Qv1k-bits/sim7080_dev_board/SIM7080.kicad_pcb

## KiCad design SIM7080.kicad_pcb (2024-02-22)

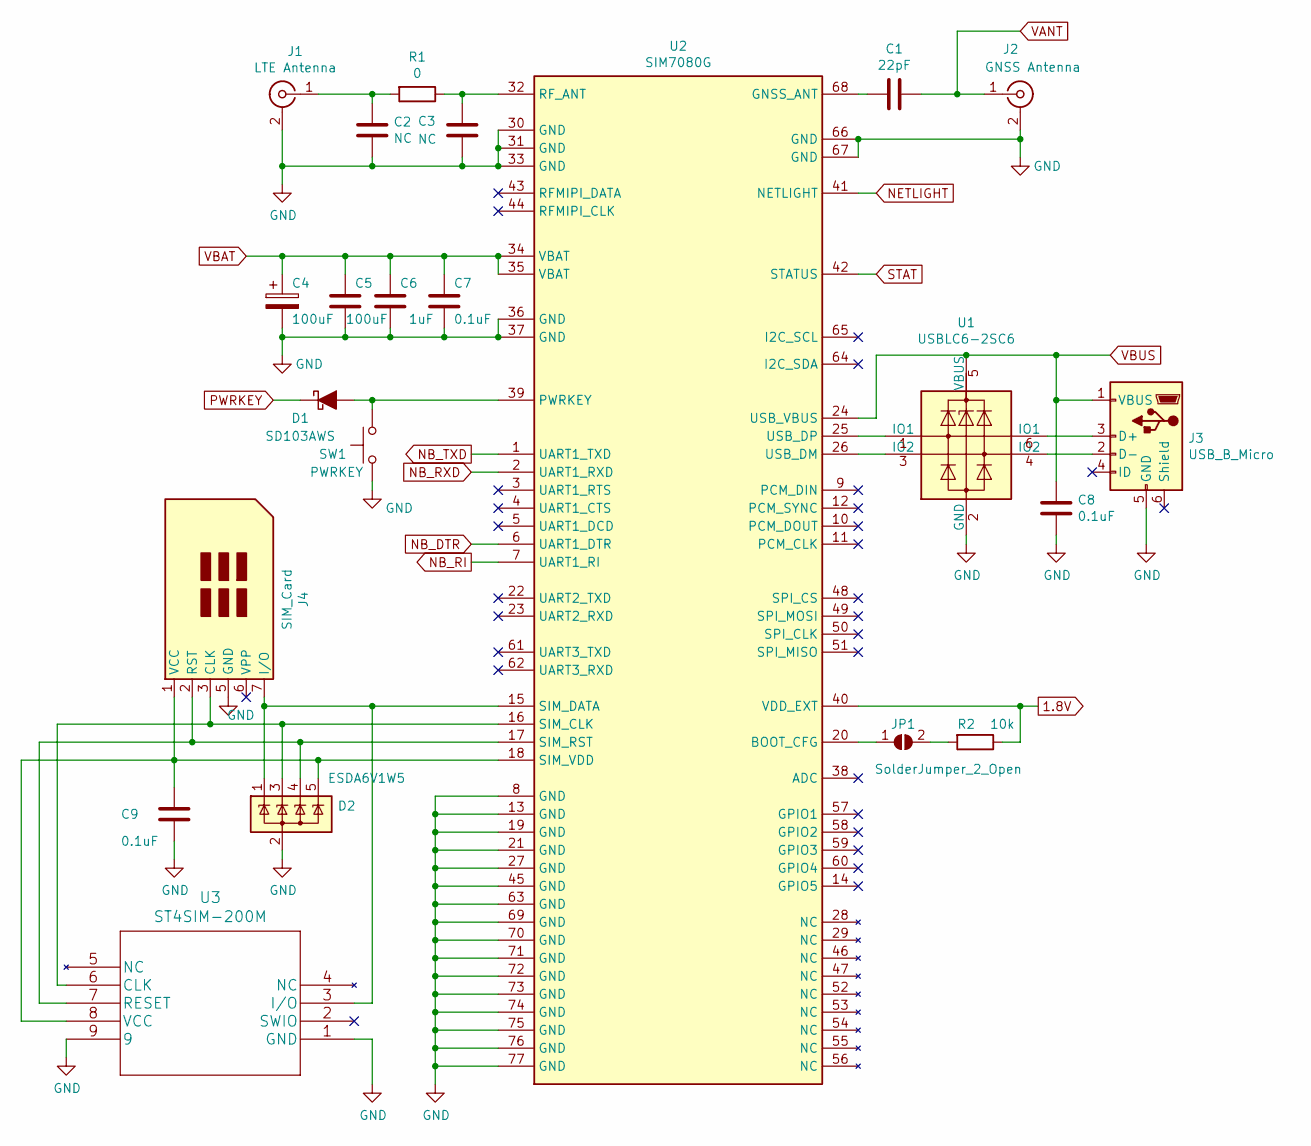
[picture p1: schematic SIM7080_module.kicad_sch, TechStudio.Design SIM7080G NB-IoT Shield]

Parts:
C1: 22pF; C_0603_1608Metric_Pad1.05x0.95mm_HandSolder
C2, C3: NC; C_0603_1608Metric_Pad1.05x0.95mm_HandSolder
C4: 100uF; CP_EIA-3528-12_Kemet-T_Pad1.50x2.35mm_HandSolder
C5: 100uF; C_1206_3216Metric_Pad1.42x1.75mm_HandSolder
C6: 1uF; C_0603_1608Metric_Pad1.05x0.95mm_HandSolder
C7, C8, C9: 0.1uF; C_0603_1608Metric_Pad1.05x0.95mm_HandSolder
D1: SD103AWS; D_SOD-323_HandSoldering
D2: ESDA6V1W5; SOT-353_SC-70-5_Handsoldering
J1: LTE Antenna; U.FL_Hirose_U.FL-R-SMT-1_Vertical
J2: GNSS Antenna; U.FL_Hirose_U.FL-R-SMT-1_Vertical
J3: USB_B_Micro; U254-051T-4BH83
J4: SIM_Card; HOAUC-HYC240-SIM-06-150_C645501
JP1: SolderJumper_2_Open; SolderJumper-2_P1.3mm_Open_Pad1.0x1.5mm
R1: 0; R_0603_1608Metric_Pad1.05x0.95mm_HandSolder
R2: 10k; R_0603_1608Metric_Pad1.05x0.95mm_HandSolder
SW1: PWRKEY; SW_TS-1101-X-X
U1: USBLC6-2SC6; SOT-23-6_Handsoldering
U2: SIM7080G
U3: ST4SIM-200M

Connections:
1.8V: R2.1, U2.40 (VDD_EXT); also elsewhere on the board
GND: C2.2, C3.2, C4.2, C5.2, C6.2, C7.2, C8.2, C9.2, D2.2 (A), J1.2 (Ext), J2.2 (Ext), J3.5 (GND), J4.5 (GND), SW1.1, U1.2 (GND), U2.8 (GND), U2.13 (GND), U2.19 (GND), U2.21 (GND), U2.27 (GND), U2.30 (GND), U2.31 (GND), U2.33 (GND), U2.36 (GND), U2.37 (GND), U2.45 (GND), U2.63 (GND), U2.66 (GND), U2.67 (GND), U2.69 (GND), U2.70 (GND), U2.71 (GND), U2.72 (GND), U2.73 (GND), U2.74 (GND), U2.75 (GND), U2.76 (GND), U2.77 (GND), U3.1 (GND), U3.9; also elsewhere on the board
NB_DTR: U2.6 (UART1_DTR); also elsewhere on the board
NB_RI: U2.7 (UART1_RI); also elsewhere on the board
NB_RXD: U2.2 (UART1_RXD); also elsewhere on the board
NB_TXD: U2.1 (UART1_TXD); also elsewhere on the board
NETLIGHT: U2.41 (NETLIGHT); also elsewhere on the board
unnamed: C1.1, U2.68 (GNSS_ANT)
unnamed: C2.1, J1.1 (In), R1.2
unnamed: C3.1, R1.1, U2.32 (RF_ANT)
unnamed: C9.1, D2.5 (K), J4.1 (VCC), U2.18 (SIM_VDD), U3.8 (VCC)
unnamed: D1.2 (A), SW1.2, U2.39 (PWRKEY)
unnamed: D2.1 (K), J4.7 (I/O), U2.15 (SIM_DATA), U3.3 (I/O)
unnamed: D2.3 (K), J4.3 (CLK), U2.16 (SIM_CLK), U3.6 (CLK)
unnamed: D2.4 (K), J4.2 (RST), U2.17 (SIM_RST), U3.7 (RESET)
unnamed: J3.2 (D-), U1.4 (IO2)
unnamed: J3.3 (D+), U1.6 (IO1)
unnamed: JP1.1 (A), U2.20 (BOOT_CFG)
unnamed: JP1.2 (B), R2.2
unnamed: U1.1 (IO1), U2.25 (USB_DP)
unnamed: U1.3 (IO2), U2.26 (USB_DM)
PWRKEY: D1.1 (K); also elsewhere on the board
STAT: U2.42 (STATUS); also elsewhere on the board
VANT: C1.2, J2.1 (In); also elsewhere on the board
VBAT: C4.1, C5.1, C6.1, C7.1, U2.34 (VBAT), U2.35 (VBAT); also elsewhere on the board
VBUS: C8.1, J3.1 (VBUS), U1.5 (VBUS), U2.24 (USB_VBUS); also elsewhere on the board

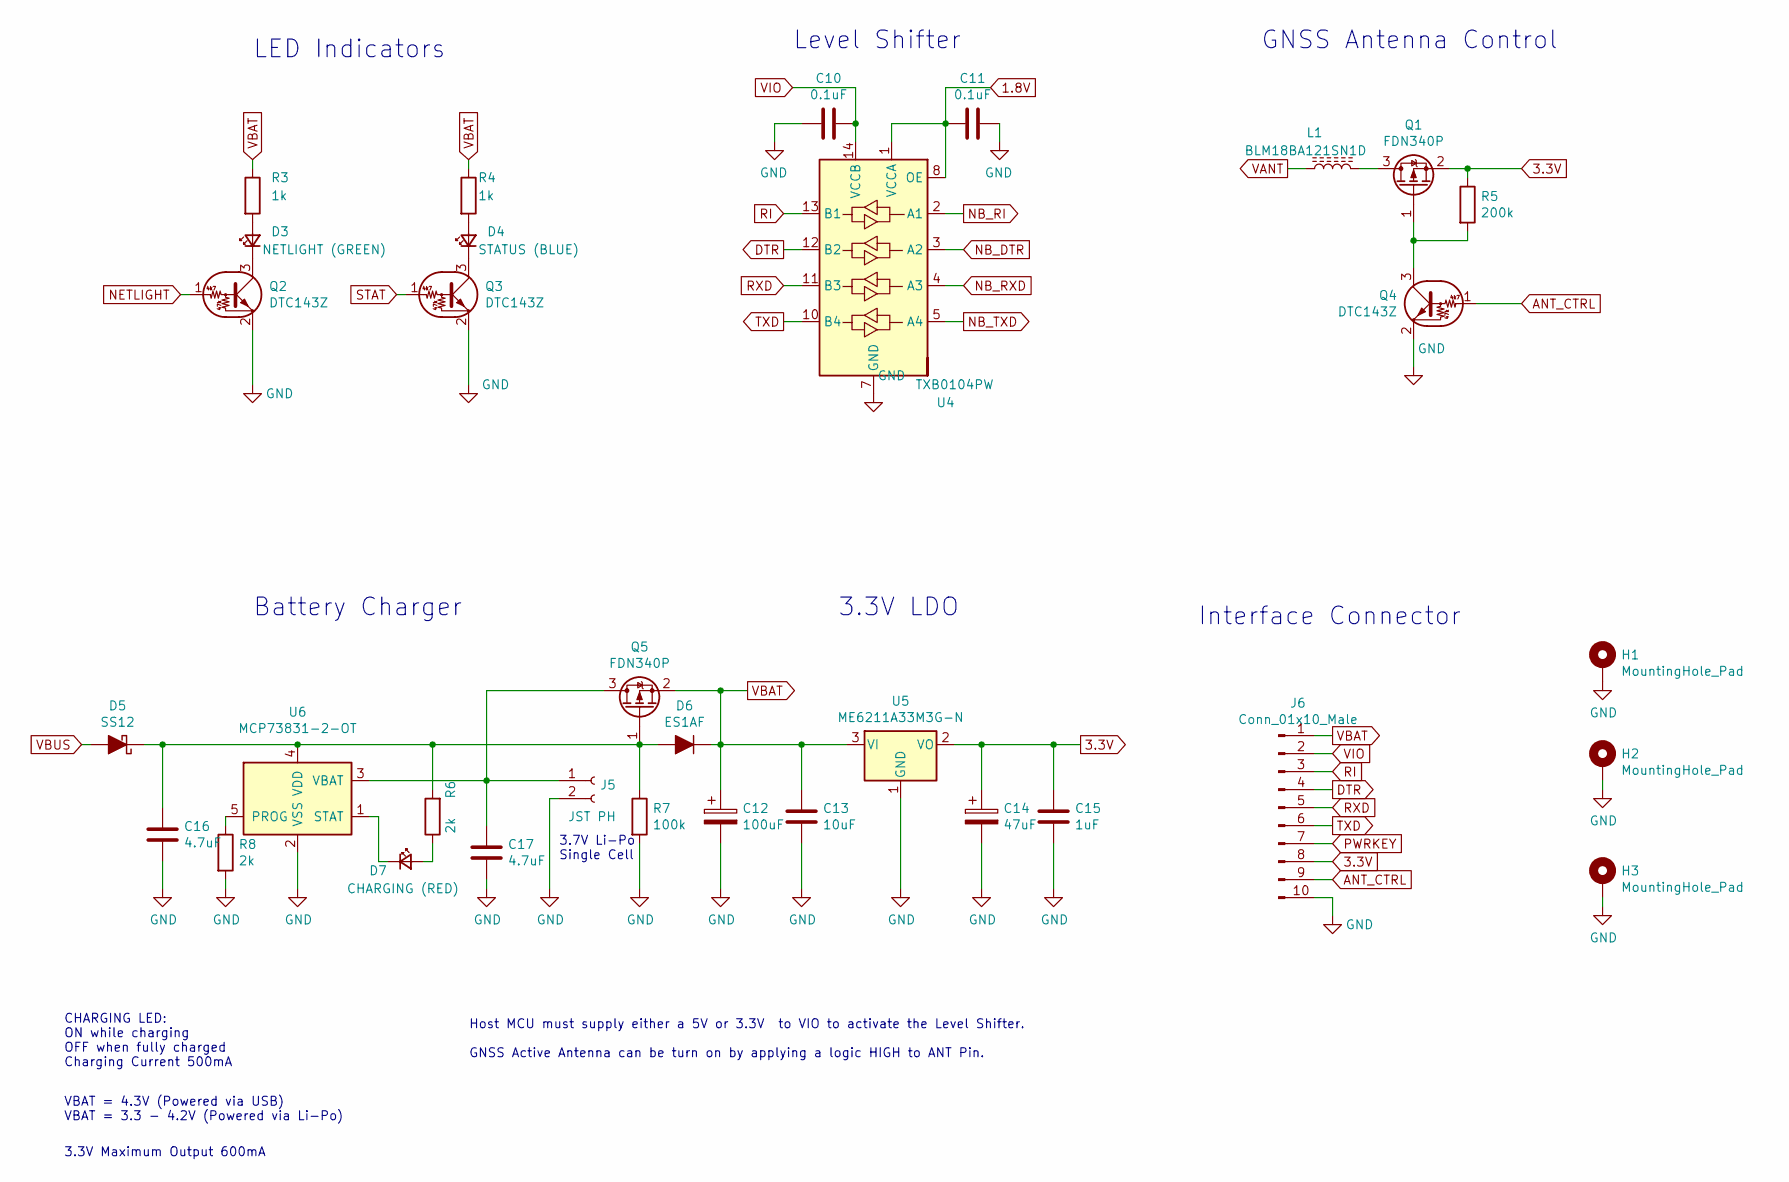
[picture p2: schematic SIM7080_peripherals.kicad_sch, TechStudio.Design SIM7080G NB-IoT Shield]

Parts:
C10, C11: 0.1uF; C_0603_1608Metric_Pad1.05x0.95mm_HandSolder
C12: 100uF; CP_EIA-3528-12_Kemet-T_Pad1.50x2.35mm_HandSolder
C13: 10uF; C_0603_1608Metric_Pad1.05x0.95mm_HandSolder
C14: 47uF; CP_EIA-3216-10_Kemet-I_Pad1.58x1.35mm_HandSolder
C15: 1uF; C_0603_1608Metric_Pad1.05x0.95mm_HandSolder
C16, C17: 4.7uF; C_0603_1608Metric_Pad1.05x0.95mm_HandSolder
D3: NETLIGHT (GREEN); LED_0603_1608Metric_Pad1.05x0.95mm_HandSolder
D4: STATUS (BLUE); LED_0603_1608Metric_Pad1.05x0.95mm_HandSolder
D5: SS12; D_SMA
D6: ES1AF; D_SMA
D7: CHARGING (RED); LED_0603_1608Metric_Pad1.05x0.95mm_HandSolder
H1, H2, H3: MountingHole_Pad; MountingHole_2.7mm_M2.5
J5: JST PH; JST_PH_S2B-PH-K_1x02_P2.00mm_Horizontal
J6: Conn_01x10_Male; PinHeader_1x10_P2.54mm_Horizontal
L1: BLM18BA121SN1D; L_0603_1608Metric_Pad1.05x0.95mm_HandSolder
Q1, Q5: FDN340P; SOT-23_Handsoldering
Q2, Q3, Q4: DTC143Z; SOT523
R3, R4: 1k; R_0603_1608Metric_Pad1.05x0.95mm_HandSolder
R5: 200k; R_0603_1608Metric_Pad1.05x0.95mm_HandSolder
R6, R8: 2k; R_0603_1608Metric_Pad1.05x0.95mm_HandSolder
R7: 100k; R_0603_1608Metric_Pad1.05x0.95mm_HandSolder
U4: TXB0104PW; TSSOP-14_4.4x5mm_P0.65mm
U5: ME6211A33M3G-N; SOT-23
U6: MCP73831-2-OT; SOT-23-5_HandSoldering

Connections:
1.8V: C11.2, U4.1 (VCCA), U4.8 (OE); also elsewhere on the board
3.3V: C14.1, C15.1, J6.8, Q1.2 (S), R5.1, U5.2 (VO)
ANT_CTRL: J6.9, Q4.1 (B)
DTR: J6.4, U4.12 (B2)
GND: C10.2, C11.1, C12.2, C13.2, C14.2, C15.2, C16.2, C17.2, H1.1, H2.1, H3.1, J5.2, J6.10, Q2.2 (E), Q3.2 (E), Q4.2 (E), R7.2, R8.2, U4.7 (GND), U5.1 (GND), U6.2 (VSS); also elsewhere on the board
NB_DTR: U4.3 (A2); also elsewhere on the board
NB_RI: U4.2 (A1); also elsewhere on the board
NB_RXD: U4.4 (A3); also elsewhere on the board
NB_TXD: U4.5 (A4); also elsewhere on the board
NETLIGHT: Q2.1 (B); also elsewhere on the board
unnamed: C16.1, D5.1 (K), D6.2 (A), Q5.1 (G), R6.2, R7.1, U6.4 (VDD)
unnamed: C17.1, J5.1, Q5.3 (D), U6.3 (VBAT)
unnamed: D3.1 (K), Q2.3 (C)
unnamed: D3.2 (A), R3.2
unnamed: D4.1 (K), Q3.3 (C)
unnamed: D4.2 (A), R4.2
unnamed: D7.1 (K), U6.1 (STAT)
unnamed: D7.2 (A), R6.1
unnamed: L1.2, Q1.3 (D)
unnamed: Q1.1 (G), Q4.3 (C), R5.2
unnamed: R8.1, U6.5 (PROG)
PWRKEY: J6.7; also elsewhere on the board
RI: J6.3, U4.13 (B1)
RXD: J6.5, U4.11 (B3)
STAT: Q3.1 (B); also elsewhere on the board
TXD: J6.6, U4.10 (B4)
VANT: L1.1; also elsewhere on the board
VBAT: C12.1, C13.1, D6.1 (K), J6.1, Q5.2 (S), R3.1, R4.1, U5.3 (VI); also elsewhere on the board
VBUS: D5.2 (A); also elsewhere on the board
VIO: C10.1, J6.2, U4.14 (VCCB)

Notes on the sheet:
LED Indicators
Interface Connector
3.7V Li-Po Single Cell
Battery Charger
Host MCU must supply either a 5V or 3.3V to VIO to activate the Level Shifter. GNSS Active Antenna can be turn on by applying a logic HIGH to ANT Pin.
Level Shifter
VBAT = 4.3V (Powered via USB) VBAT = 3.3 - 4.2V (Powered via Li-Po)
3.3V LDO
CHARGING LED: ON while charging OFF when fully charged Charging Current 500mA
GNSS Antenna Control
3.3V Maximum Output 600mA

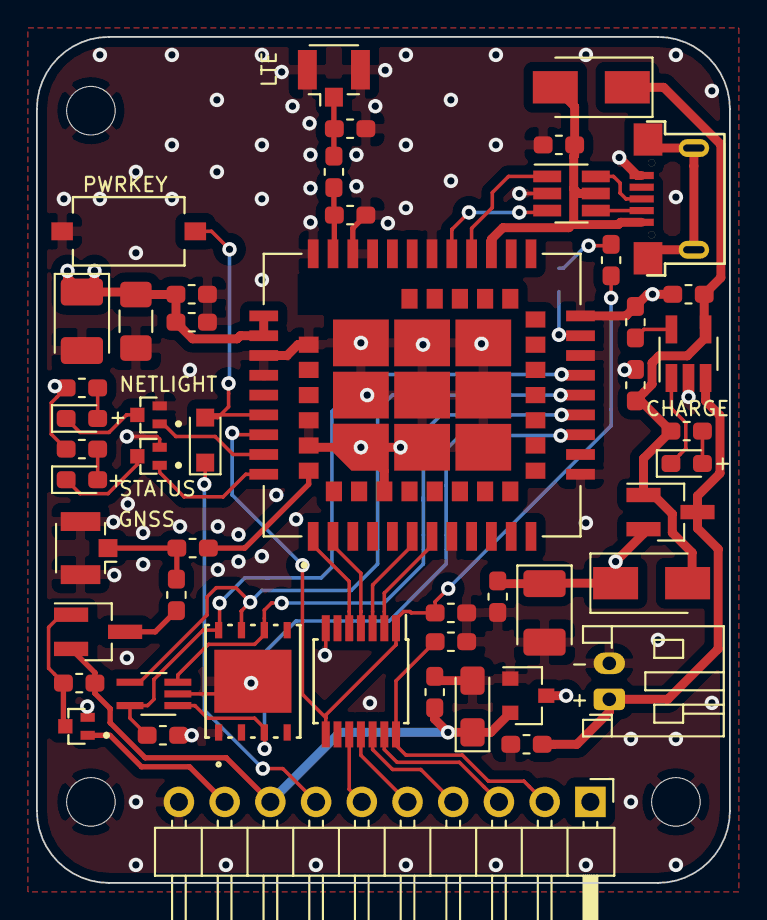
[picture p3: board SIM7080.kicad_pcb from above]

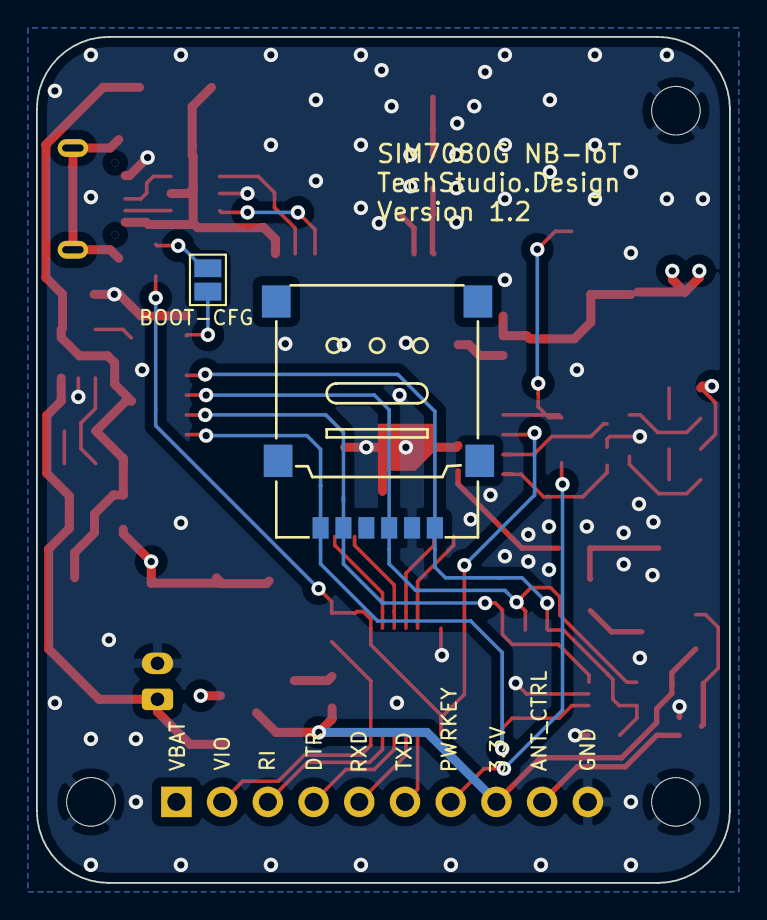
[picture p4: board SIM7080.kicad_pcb from below]

Board: 4 copper layers, 38.5 x 47.0 mm, 55 parts (2 on the bottom side), 44 nets.
