Qv1k-bits/sim7080_dev_board/(notices)

Notices in the files:
SIM7080.kicad_pcb:
Copyright: Tech Studio Design, 2021
